Recycling-Werkstatt-insel-eV/Vertikale-Beete/BOM.xlsx

Manual Name | Specifications | Amount | Price | Shipping | Total | Vendor | Notes
Mould
Aluminum | 200x200x50 mm | 3 | 63.36 € | 7.00 € | 197.08 € | https://www.ebay.de/itm/143229638180 | If everything works out nicely, you just need 2 blocks. Just to be sure we suggest to order 1-2 blocks additionally
Irrigation System 5V
Soul moisture sensors | Capacitive Sensors | 2 | 2.80 € | 5.95 € | 11.55 € | https://www.reichelt.de/entwicklerboards-feuchtesensor-bodenfeuchte--debo-cap-sens-p223620.html?PROVID=2788
Vinyl Tube PVC | outside diameter 10mm, inside diameter 7mm, lenght: 1m | 1 | 0.46 € | 4.90 € | 5.36 € | https://www.rst-versand.de/PVC-Klarsichtschlauch-7-10-mm
Capacitive switch | Touch | 1 | 1.90 € | 4.90 € | 6.80 € | https://funduinoshop.com/bauelemente/taster-und-schalter/schalter/kapazitiver-schalter-beleuchtet-led-diverse-farben
Submersible pump | DC 5V | 2 | 3.02 € | 5.95 € | 11.99 € | https://www.pollin.de/p/tauchpumpe-3-5v-liegend-330135
Relay card | 1 channel, 5V, for Arduino | 2 | 2.70 € | 4.90 € | 10.30 € | https://funduinoshop.com/bauelemente/taster-und-schalter/relais/relaiskarte-1-kanal-5v/230v-fuer-arduino
Arduino Nano |  | 1 | 6.75 € | 3.99 € | 10.74 € | https://www.roboter-bausatz.de/p/nano-mega328p-v3.0-usb-ch340g-modul?sPartner=8
LCD display |  | 1 | 6.90 € | 4.90 € | 11.80 € | https://funduinoshop.com/elektronische-module/displays/lcd/20x04-2004-i2c-lcd-modul-hintergrundbeleuchtung-blau
humidity + temperature sensor | for arduino | 1 | 7.90 € | 4.90 € | 12.80 € | https://funduinoshop.com/elektronische-module/sensoren/feuchtigkeit/dht11-temperatur-und-feuchtigkeitssensor-mit-xh2.54-buchse
breadboard | 830 | 1 | 2.10 € | 4.90 € | 7.00 € | https://funduinoshop.com/bauelemente/steckbretter-und-platinen/steckbretter/breadboard-steckbrett-mit-830-kontakten
Film resistor | 1K ohm | 1 | 0.10 € | 3.99 € | 4.09 € | https://de.elv.com/sicherungswiderstand-1k-091814
bell / control wire | for wireing on the breadboard (not necessary, but easier for the build) | 1 | 2.90 € | 2.99 € | 5.89 € | https://www.ebay.de/itm/155358498441?hash=item242c168e89:g:TnAAAOSwQmtkAMKJ&var=455564855989
jumper wire male/female DUPONT |  | 1 | 1.20 € | 4.90 € | 6.10 € | https://funduinoshop.com/bauelemente/kabelsysteme/jumper-kabel/40-stueck-breadboardkabel-maennlich/weiblich-20cm
PETG filament | for 3D-printing | 1 | 15.90 € | 4.90 € | 20.80 € | https://funduinoshop.com/3d-druck/3d-druckmaterial/petg/creality-cr-petg-filament
Water tank |  | 1 | 9.90 € | 4.95 € | 14.85 € | https://www.profichemie.com/1-kanister-10Ltr-Kunststoff-mit-Auslaufhahn
Galvanized screws | V4A (for water contact), voltage measurement in the water tank | 4 | 0.12 € | 5.00 € | 6.48 € | https://www.edelstahl24.com/sechskantschrauben-ohne-schaft-v4a-17791.html
M3 Cylinder Screws | length 12, you need 4, the pack contains 500 screws | 1 | 6.64 € | 5.90 € | 12.54 € | https://www.schraubenluchs.de/500-Stk-Zylinderschrauben-DIN-84-A2-M-3-x-12
M3 Cylinder Screws | lenght 5, you need 8, the pack contains 500 screws | 1 | 7.07 € | 5.90 € | 12.97 € | https://www.schraubenluchs.de/500-Stk-Zylinderschrauben-DIN-84-A2-M-3-x-5
Power Adapter | 5V, 1A ; for 12V irrigation system please choose 2A | 1 | 3.56 € | 1.79 € | 5.35 € | https://www.ebay.de/itm/223575546448?chn=ps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 | For testing or indoor operation (without solar power)
10 pin breadboard cable, jumper cable - 1.27mm |  | 1 | 0.65 € | 4.90 € | 5.55 € | https://funduinoshop.com/bauelemente/kabelsysteme/jumper-kabel/10-poliges-breadboardkabel-jumper-kabel-1.27mm
Power Supply 5V
Battery | 14500 battery type, 3,7V | 1 | 3.70 € | 3.95 € | 7.65 € | https://www.berrybase.de/sony-us14500vr2b-lithium-ionen-akku-715mah
Solarpanel | 6W, 5V/1A | 1 | 19.99 € | 4.99 € | 24.98 € | https://www.amazon.de/Mini-Solar-USB-Ladepanel-FlexSolar-Hochleistungs-Monokristallinmodul-Powerbank-Campinglaternen/dp/B09JFYPDNC
Solar Power Management Module | for 6V-24V Solar Panels | 1 | 10.70 € | 3.95 € | 14.65 € | https://www.berrybase.de/solar-power-management-modul-fuer-6v-24v-solar-panel
Plastic material
1 kg recycled PP flakes |  | 2 | 10.00 € | 4.99 € | 24.99 € | https://bazar.preciousplastic.com/raw-material/plastic/pet-plastic-flakes-shredded-purely-sorted-light-blue-clone/ | The product needs up to 2 kg flakes, but for good results we suggest to buy more
 |  |  |  | Total Price | 452.31 €
