Recycling-Werkstatt-insel-eV/Vertikale-Beete/CAD Files/Pflanzenmodul 1 extrudierte form.stp

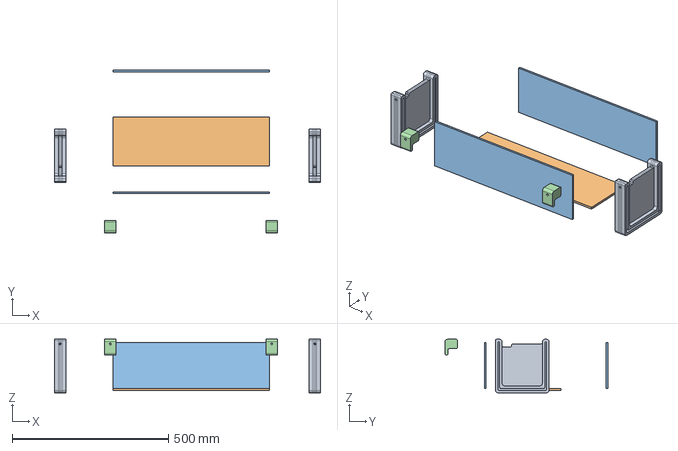
[picture p19: CAD file, 2024-12-17]
CAD Files/Pflanzenmodul 1 extrudierte form.stp
850.0 x 521.3 x 171.0 mm
