Recycling-Werkstatt-insel-eV/Vertikale-Beete/CAD Files/Pflanzenmodul 1 Werkzeug.stp

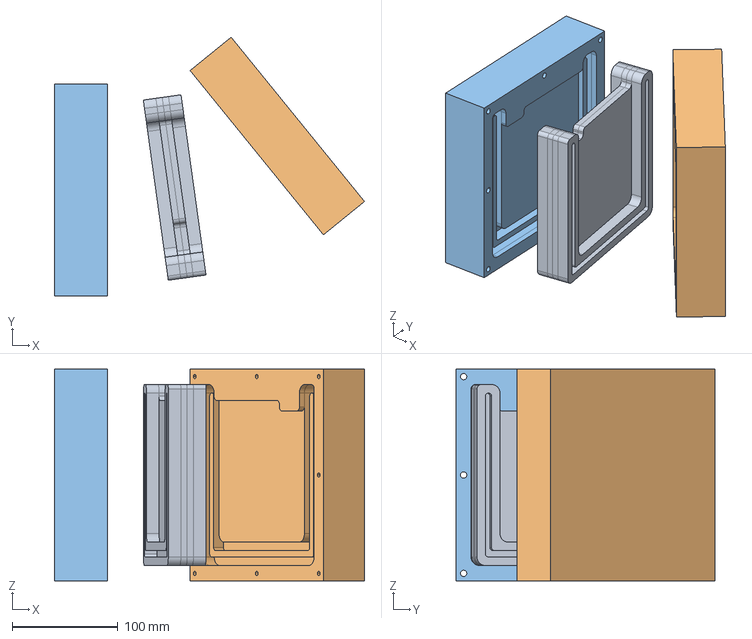
[picture p20: CAD file, 2024-12-17]
CAD Files/Pflanzenmodul 1 Werkzeug.stp
293.0 x 244.4 x 200.0 mm
