Recycling-Werkstatt-insel-eV/Vertikale-Beete/CAD Files/Pflanzenmodul 2 gefräste form.stp

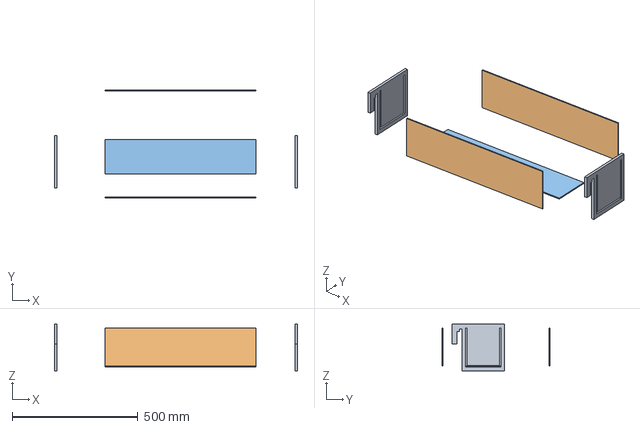
[picture p21: CAD file, 2024-12-17]
CAD Files/Pflanzenmodul 2 gefräste form.stp
966.2 x 430.2 x 186.0 mm
